JamieT1701/SprinklerSystemMonitor/docs/assets/fusion-r1-cad-isometric.png

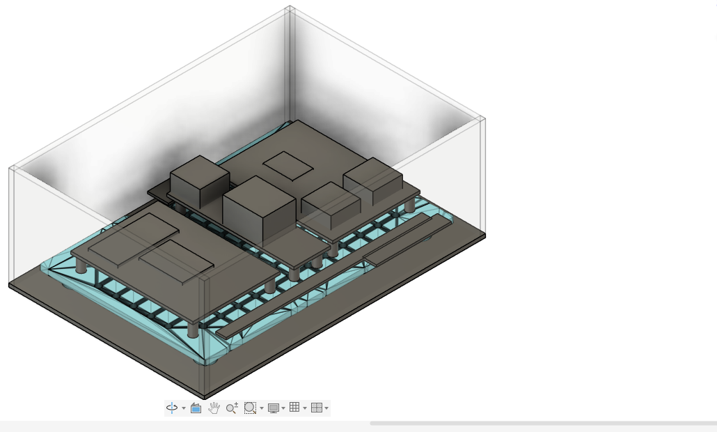
docs/assets/fusion-r1-cad-isometric.png
