JamieT1701/SprinklerSystemMonitor/docs/assets/fusion-r1-cad-top.png

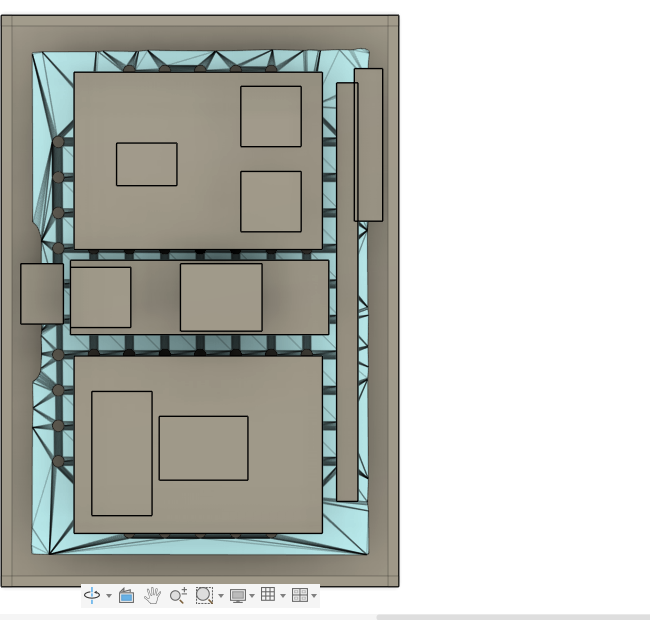
docs/assets/fusion-r1-cad-top.png
