JamieT1701/SprinklerSystemMonitor/hardware/project-plate-p3/Project_Plate_P3_Wall_1p2.scad

// Device Lab project plate P3 - explicit 1.2mm wall allowance.
// FIT PROTOTYPE ONLY. Trace is the OUTSIDE of the box.
// Preserve the original PDF scale; do not stretch shape to earlier inside dimensions.
// Inward offset from traced outside: 1.2 wall + 3.0 rails + 0.4 slip = 4.6mm/edge.
// Derived geometry, not a calibrated measurement. Print fit_frame FIRST.
// Print broad flat face DOWN, posts UP. Install posts against the case floor.
// Case screws enter from outside; maximum 5mm projection past inner case wall.
// Board electronics still require separate insulating spacers above the plate.
part = "plate"; // "plate" or "fit_frame"
$fn=64;
plate_t=3;
post_h=6;
post_d=10;
post_base_d=14;
post_base_h=1.5;
pilot_d=2.5;
pilot_depth=7;
frame_web=2.8;
plate_w=95.159863;
plate_h=142.652434;
outline_points=[
  [0.294049, 1.180076],
  [0.260040, 1.639348],
  [0.432772, 48.932559],
  [0.601474, 49.063298],
  [0.952431, 49.364711],
  [1.271338, 49.699850],
  [1.554970, 50.065326],
  [1.800459, 50.457442],
  [2.005320, 50.872234],
  [2.167482, 51.305504],
  [2.630536, 52.761942],
  [2.751857, 53.226106],
  [2.824175, 53.700381],
  [2.846703, 54.179608],
  [2.757133, 71.411275],
  [2.945400, 79.410003],
  [2.935393, 79.840190],
  [2.885233, 80.267560],
  [2.777472, 80.920262],
  [2.889014, 85.889084],
  [2.885313, 86.203713],
  [2.704809, 90.127435],
  [2.663019, 90.569498],
  [2.578801, 91.005473],
  [2.452940, 91.431296],
  [2.286609, 91.843000],
  [2.081359, 92.236749],
  [1.839100, 92.608874],
  [1.562091, 92.955908],
  [1.252912, 93.274617],
  [0.914446, 93.562030],
  [0.436639, 93.929597],
  [0.368577, 94.184154],
  [0.527288, 101.235070],
  [0.524769, 101.522658],
  [0.313543, 106.797013],
  [0.221874, 135.004009],
  [0.217324, 135.194154],
  [0.000000, 140.063598],
  [0.123153, 142.284285],
  [0.432763, 142.398547],
  [5.043821, 142.557359],
  [94.486883, 142.652434],
  [94.828464, 142.521528],
  [94.910346, 142.441603],
  [95.028913, 142.152384],
  [94.957326, 130.312998],
  [94.713567, 128.596454],
  [94.674238, 128.191567],
  [94.670833, 127.784788],
  [94.905461, 121.244903],
  [94.722513, 93.261797],
  [94.731948, 92.935726],
  [94.938831, 89.727296],
  [94.775366, 84.132808],
  [94.774694, 83.889526],
  [94.981464, 75.160477],
  [94.780731, 73.394123],
  [94.751364, 72.896552],
  [94.648440, 51.219704],
  [94.678131, 50.675609],
  [94.829712, 49.349125],
  [94.767069, 33.765046],
  [94.799063, 33.204656],
  [94.872310, 32.800128],
  [94.856310, 32.724092],
  [94.786010, 32.286162],
  [94.758213, 31.843496],
  [94.733656, 30.148049],
  [94.750823, 29.678861],
  [94.815726, 29.213867],
  [94.910010, 28.829906],
  [94.769194, 27.621842],
  [94.741615, 27.264947],
  [94.741871, 26.906988],
  [94.986806, 20.730285],
  [94.737719, 17.795792],
  [94.721340, 17.375939],
  [94.765570, 10.768535],
  [94.607847, 9.948523],
  [94.547516, 9.533778],
  [94.525185, 9.115264],
  [94.541037, 8.696454],
  [95.159863, 1.294164],
  [95.024088, 0.606153],
  [93.921281, 0.091733],
  [92.731672, 0.000000],
  [90.494105, 0.381147],
  [90.023146, 0.436575],
  [89.548984, 0.443223],
  [86.780503, 0.339221],
  [81.419361, 0.572422],
  [80.869340, 0.563424],
  [78.367811, 0.372472],
  [77.573392, 0.513822],
  [77.112075, 0.572035],
  [76.647238, 0.583379],
  [67.939856, 0.355516],
  [51.990138, 0.739395],
  [51.825795, 0.740413],
  [32.773962, 0.518146],
  [30.173557, 0.835775],
  [29.554986, 0.869308],
  [20.159370, 0.745019],
  [18.850867, 0.920363],
  [18.250589, 0.961104],
  [3.060353, 0.996357]
];
posts=[
  [10.000000, 10.000000],
  [85.159863, 10.000000],
  [10.000000, 132.652434],
  [85.159863, 132.652434]
];
hole_points=[
  [7.579931, 26.326217],
  [7.579931, 36.326217],
  [7.579931, 46.326217],
  [7.579931, 56.326217],
  [7.579931, 66.326217],
  [7.579931, 76.326217],
  [7.579931, 86.326217],
  [7.579931, 96.326217],
  [7.579931, 106.326217],
  [7.579931, 116.326217],
  [17.579931, 16.326217],
  [17.579931, 26.326217],
  [17.579931, 36.326217],
  [17.579931, 46.326217],
  [17.579931, 56.326217],
  [17.579931, 66.326217],
  [17.579931, 76.326217],
  [17.579931, 86.326217],
  [17.579931, 96.326217],
  [17.579931, 106.326217],
  [17.579931, 116.326217],
  [17.579931, 126.326217],
  [27.579931, 6.326217],
  [27.579931, 16.326217],
  [27.579931, 26.326217],
  [27.579931, 36.326217],
  [27.579931, 46.326217],
  [27.579931, 56.326217],
  [27.579931, 66.326217],
  [27.579931, 76.326217],
  [27.579931, 86.326217],
  [27.579931, 96.326217],
  [27.579931, 106.326217],
  [27.579931, 116.326217],
  [27.579931, 126.326217],
  [27.579931, 136.326217],
  [37.579931, 6.326217],
  [37.579931, 16.326217],
  [37.579931, 26.326217],
  [37.579931, 36.326217],
  [37.579931, 46.326217],
  [37.579931, 56.326217],
  [37.579931, 66.326217],
  [37.579931, 76.326217],
  [37.579931, 86.326217],
  [37.579931, 96.326217],
  [37.579931, 106.326217],
  [37.579931, 116.326217],
  [37.579931, 126.326217],
  [37.579931, 136.326217],
  [47.579931, 6.326217],
  [47.579931, 16.326217],
  [47.579931, 26.326217],
  [47.579931, 36.326217],
  [47.579931, 46.326217],
  [47.579931, 56.326217],
  [47.579931, 66.326217],
  [47.579931, 76.326217],
  [47.579931, 86.326217],
  [47.579931, 96.326217],
  [47.579931, 106.326217],
  [47.579931, 116.326217],
  [47.579931, 126.326217],
  [47.579931, 136.326217],
  [57.579931, 6.326217],
  [57.579931, 16.326217],
  [57.579931, 26.326217],
  [57.579931, 36.326217],
  [57.579931, 46.326217],
  [57.579931, 56.326217],
  [57.579931, 66.326217],
  [57.579931, 76.326217],
  [57.579931, 86.326217],
  [57.579931, 96.326217],
  [57.579931, 106.326217],
  [57.579931, 116.326217],
  [57.579931, 126.326217],
  [57.579931, 136.326217],
  [67.579931, 6.326217],
  [67.579931, 16.326217],
  [67.579931, 26.326217],
  [67.579931, 36.326217],
  [67.579931, 46.326217],
  [67.579931, 56.326217],
  [67.579931, 66.326217],
  [67.579931, 76.326217],
  [67.579931, 86.326217],
  [67.579931, 96.326217],
  [67.579931, 106.326217],
  [67.579931, 116.326217],
  [67.579931, 126.326217],
  [67.579931, 136.326217],
  [77.579931, 16.326217],
  [77.579931, 26.326217],
  [77.579931, 36.326217],
  [77.579931, 46.326217],
  [77.579931, 56.326217],
  [77.579931, 66.326217],
  [77.579931, 76.326217],
  [77.579931, 86.326217],
  [77.579931, 96.326217],
  [77.579931, 106.326217],
  [77.579931, 116.326217],
  [77.579931, 126.326217],
  [87.579931, 26.326217],
  [87.579931, 36.326217],
  [87.579931, 46.326217],
  [87.579931, 56.326217],
  [87.579931, 66.326217],
  [87.579931, 76.326217],
  [87.579931, 86.326217],
  [87.579931, 96.326217],
  [87.579931, 106.326217],
  [87.579931, 116.326217]
];

assert(pilot_depth < plate_t+post_h,"Pilot must remain blind");
module outline(){polygon(outline_points);}
module plate_profile(){
 difference(){outline();for(p=hole_points)translate(p)circle(d=3.4);}
}
module frame_profile(){
 difference(){
  outline();
  difference(){
   offset(delta=-frame_web)outline();
   // Keep reinforced mounting islands connected to perimeter.
   for(p=posts)translate(p)circle(d=15.5);
  }
 }
}
module post(x,y){
 translate([x,y,plate_t-0.01]){
  cylinder(h=post_base_h+0.01,d1=post_base_d,d2=post_d);
  cylinder(h=post_h+0.01,d=post_d);
 }
}
module pilot(x,y){
 ztop=plate_t+post_h;
 translate([x,y,ztop-pilot_depth])cylinder(h=pilot_depth+0.02,d=pilot_d);
 translate([x,y,ztop-0.4])cylinder(h=0.42,d1=pilot_d,d2=3.1);
}
module assembly(is_frame=false){
 difference(){
  union(){
   linear_extrude(height=plate_t)
    if(is_frame)frame_profile();else plate_profile();
   for(p=posts)post(p[0],p[1]);
  }
  for(p=posts)pilot(p[0],p[1]);
 }
}
if(part=="plate")assembly();
else if(part=="fit_frame")assembly(true);
else assert(false,"Unknown part");
