JamieT1701/SprinklerSystemMonitor/(list of files, cad)

Other CAD files:
cad/fusion/DeviceLabR1Assembly/R1_PROVISIONAL_Assembly.f3d
