JamieT1701/SprinklerSystemMonitor/(commit log)

2026-11-11 chore: preserve verified 2026 ESP32-S3 ADC and Ethernet firmware
2026-11-11 docs: preserve November 2026 sprinkler monitor wiring and resume checkpoint
2026-11-11 feat: prepare DS18B20 and ADS1115 sensor diagnostics for guarded OTA deployment
2026-11-11 docs: record live PoE recovery and pending sensor firmware deployment
2026-11-11 Guard sensor diagnostics: disable A0 sampling until electrical verification
2026-11-11 Add compile-verified provisional pressure ADC diagnostic firmware v4
2026-11-11 Add sprinkler monitor perfboard carrier v1 design, netlist, bench tests and safe prototype constraints
2026-11-11 Revise Device Lab carrier for two existing 50x70 mm perfboards
2026-11-11 Revise beginner perfboard guide for two 4.7k resistors and onboard DS18B20 pull-up
2026-11-11 Mark earlier 50x70 guide superseded; temperature pull-up and R3 updated in v4
2026-11-11 Record latest DS18B20 pull-up correction and 4.7k pressure divider design
2026-11-11 Prepare pressure diagnostics v5 for 10k/14.7k divider with onboard temperature pull-up
2026-11-11 Reconcile exactly two sensor terminals with verified netlist and bench guide R6
2026-11-11 Add simple PETG project plate with integral case-mounting posts
2026-11-11 Add scan-informed project plate P2 and matching fit-frame prototype
2026-11-11 Document scan calibration, interior-fit assumptions and P2 validation
2026-11-11 Account explicitly for 1.2mm case walls in scan-derived project plate P3
2026-11-11 Document confirmed P4 PETG enclosure plate and M3 insert mounting in bench guide
2026-11-11 Update live bench guide with P4 verified fit, PETG and M3 heat-set mount steps
2026-11-12 Record Device Lab Board A physical assembly handoff and exact hole map
2026-11-12 docs(device-lab): checkpoint alternate-hole jumper routing before Board A soldering
2026-11-12 cad: preserve approved P4 STL and Fusion reference
    Exact-size P4 mesh recovered from Oscar, imported and verified in Fusion. Record approved artifact checksum, cloud CAD reference and reproducible Python import. Preserve Board A electrical and physical acceptance gates.
2026-11-12 cad: add provisional industrial R1 enclosure assembly
    Record a real Fusion concept around unchanged accepted P4 mesh: two 70x50 board envelopes, ESP32 PoE, support and wiring zones, exported F3D, real CAD captures, fit gates. Preserve all hardware acceptance boundaries.
2026-11-12 cad: detail R2 warehouse monitor and mobile 3D viewer
    Preserve original P4 mesh and corrected floor height, add a detailed but provisional Fusion source, source-derived technical views, a touch 3D browser viewer, manifold cable-saddle print coupon, 46 passing checks and explicit physical-fit/R2 execution gates.
2026-11-12 cad: verify and save native Fusion R2 assembly
    Owner unlocked Oscar; generated and exported native R2 Fusion design, saved distinct CAD hub document, preserved unchanged approved P4 mesh, verified archive checksum and screenshot, and upgraded regression suite to 51 tests. Physical dry-fit remains open.
2026-11-13 cad: add P4-compatible 70mm PCB edge-clip fit-test generator
2026-11-13 docs: record measured P4 hole geometry and 70mm board edge mount validation gates
2026-11-13 cad: add owner-fit-tested P4 profile elongated PCB mounting rails
2026-11-13 docs: mark clip physical fit and provide P4 rail installation and anti-slide gates
2026-11-13 docs: record owner-reported JST assembly and Monday unpowered bring-up gates
2026-11-13 docs: direct old Board-A handoff to latest Monday wired-build checkpoint
2026-11-13 docs: scope provisional single-board solderable sprinkler-monitor PCB after bench validation
2026-11-13 docs: analyze Fusion licensing, hybrid PCB architecture, electrical protection and fabrication gates
2026-11-13 research: track blind Claude Gemini comparison and hash identical prompt
